18650official/HFUT-Innov-Project-InjectSystem/docs/pcb/V1.0/Schematic_monitor1_2024-12-04.pdf

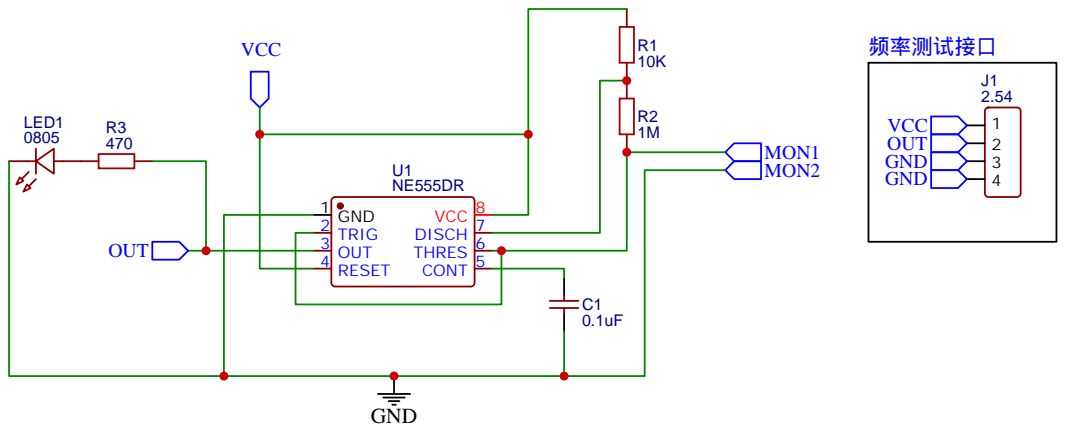
[picture p1: page 1]
