18650official/HFUT-Innov-Project-InjectSystem/firmware/stm32/Hardware/Encoder.c

#include "Encoder.h"

int16_t Encoder_Count;					//全局变量，用于计数旋转编码器的增量值
int8_t Encoder_ButtonState = 0;
int16_t t;

/**
  * 函    数：旋转编码器初始化
  * 参    数：无
  * 返 回 值：无
  */
void Encoder_Init(void)
{
	/*开启时钟*/
	RCC_APB2PeriphClockCmd(RCC_APB2Periph_GPIOA, ENABLE); //开启GPIOA时钟
	RCC_APB2PeriphClockCmd(RCC_APB2Periph_AFIO, ENABLE); 
	
	/*GPIO初始化*/
	GPIO_InitTypeDef GPIO_InitStructure;
	GPIO_InitStructure.GPIO_Mode = GPIO_Mode_IN_FLOATING;
	GPIO_InitStructure.GPIO_Pin = GPIO_Pin_5 | GPIO_Pin_6;
	GPIO_InitStructure.GPIO_Speed = GPIO_Speed_50MHz;
	GPIO_Init(GPIOA, &GPIO_InitStructure);

    GPIO_InitStructure.GPIO_Mode = GPIO_Mode_IPU; //设置按键端子为下拉输入。高电平触发
	GPIO_InitStructure.GPIO_Pin = GPIO_Pin_7;
	GPIO_InitStructure.GPIO_Speed = GPIO_Speed_50MHz;
	GPIO_Init(GPIOA, &GPIO_InitStructure);
	
	/*AFIO选择中断引脚*/
	GPIO_EXTILineConfig(GPIO_PortSourceGPIOA, GPIO_PinSource5);//将外部中断的0号线映射到GPIOB，即选择PB0为外部中断引脚
	GPIO_EXTILineConfig(GPIO_PortSourceGPIOA, GPIO_PinSource6);//将外部中断的1号线映射到GPIOB，即选择PB1为外部中断引脚
	GPIO_EXTILineConfig(GPIO_PortSourceGPIOA, GPIO_PinSource7);//将外部中断的1号线映射到GPIOB，即选择PB1为外部中断引脚
	
	/*EXTI初始化*/
	EXTI_InitTypeDef EXTI_InitStructure;						//定义结构体变量
	EXTI_InitStructure.EXTI_Line = EXTI_Line5 | EXTI_Line6;		//选择配置外部中断的0号线和1号线
	EXTI_InitStructure.EXTI_LineCmd = ENABLE;					//指定外部中断线使能
	EXTI_InitStructure.EXTI_Mode = EXTI_Mode_Interrupt;			//指定外部中断线为中断模式
	EXTI_InitStructure.EXTI_Trigger = EXTI_Trigger_Falling;		//指定外部中断线为下降沿触发
	EXTI_Init(&EXTI_InitStructure);								//将结构体变量交给EXTI_Init，配置EXTI外设

    EXTI_InitStructure.EXTI_Line = EXTI_Line7;
	EXTI_InitStructure.EXTI_LineCmd = ENABLE;					//指定外部中断线使能
	EXTI_InitStructure.EXTI_Mode = EXTI_Mode_Interrupt;			//指定外部中断线为中断模式
	EXTI_InitStructure.EXTI_Trigger = EXTI_Trigger_Falling;		//指定外部中断线为下降沿触发
	EXTI_Init(&EXTI_InitStructure);	
	
	/*NVIC中断分组*/
	NVIC_PriorityGroupConfig(NVIC_PriorityGroup_2);				//配置NVIC为分组2
																//即抢占优先级范围：0~3，响应优先级范围：0~3
																//此分组配置在整个工程中仅需调用一次
																//若有多个中断，可以把此代码放在main函数内，while循环之前
																//若调用多次配置分组的代码，则后执行的配置会覆盖先执行的配置
	
	/*NVIC配置*/
	NVIC_InitTypeDef NVIC_InitStructure;						//定义结构体变量
	NVIC_InitStructure.NVIC_IRQChannel = EXTI9_5_IRQn;			//选择配置NVIC的EXTI9-5线
	NVIC_InitStructure.NVIC_IRQChannelCmd = ENABLE;				//指定NVIC线路使能
	NVIC_InitStructure.NVIC_IRQChannelPreemptionPriority = 1;	//指定NVIC线路的抢占优先级为1
	NVIC_InitStructure.NVIC_IRQChannelSubPriority = 2;			//指定NVIC线路的响应优先级为1
	NVIC_Init(&NVIC_InitStructure);								//将结构体变量交给NVIC_Init，配置NVIC外设
}

/**
  * 函    数：旋转编码器获取增量值
  * 参    数：无
  * 返 回 值：自上此调用此函数后，旋转编码器的增量值
  */
int16_t Encoder_Get(void)
{
	/*使用Temp变量作为中继，目的是返回Encoder_Count后将其清零*/
	/*在这里，也可以直接返回Encoder_Count
	  但这样就不是获取增量值的操作方法了
	  也可以实现功能，只是思路不一样*/
	int16_t Temp;
	Temp = Encoder_Count;
	Encoder_Count = 0;
	return Temp;
}

int8_t Encoder_Readkey(void)
{
    if(Encoder_ButtonState)
    {
        Encoder_ButtonState = 0;
        return 1;
    }
    else return 0;
}

/**
  * 函    数：EXTI0外部中断函数
  * 参    数：无
  * 返 回 值：无
  * 注意事项：此函数为中断函数，无需调用，中断触发后自动执行
  *           函数名为预留的指定名称，可以从启动文件复制
  *           请确保函数名正确，不能有任何差异，否则中断函数将不能进入
  */
void EXTI9_5_IRQHandler(void)
{
	if (EXTI_GetITStatus(EXTI_Line6) == SET)		//判断是否是外部中断0号线触发的中断
	{
		/*如果出现数据乱跳的现象，可再次判断引脚电平，以避免抖动*/
		if (GPIO_ReadInputDataBit(GPIOA, GPIO_Pin_6) == 0)
		{
			if (GPIO_ReadInputDataBit(GPIOA, GPIO_Pin_5) == 0)		//PB0的下降沿触发中断，此时检测另一相PB1的电平，目的是判断旋转方向
			{
				Encoder_Count ++;					//此方向定义为反转，计数变量自减
			}
		}
		EXTI_ClearITPendingBit(EXTI_Line6);			//清除外部中断0号线的中断标志位
													//中断标志位必须清除
													//否则中断将连续不断地触发，导致主程序卡死
	}
	
    else if (EXTI_GetITStatus(EXTI_Line5) == SET)		//判断是否是外部中断0号线触发的中断
	{
		/*如果出现数据乱跳的现象，可再次判断引脚电平，以避免抖动*/
		if (GPIO_ReadInputDataBit(GPIOA, GPIO_Pin_5) == 0)
		{
			if (GPIO_ReadInputDataBit(GPIOA, GPIO_Pin_6) == 0)		//PB0的下降沿触发中断，此时检测另一相PB1的电平，目的是判断旋转方向
			{
				Encoder_Count --;					//此方向定义为反转，计数变量自减
			}
		}
		EXTI_ClearITPendingBit(EXTI_Line5);			//清除外部中断0号线的中断标志位
													//中断标志位必须清除
													//否则中断将连续不断地触发，导致主程序卡死
	}
	
    else if (EXTI_GetITStatus(EXTI_Line7) == SET)		//按键输入
	{
		t = 6000;
		while(t--);
		while(GPIO_ReadInputDataBit(GPIOA, GPIO_Pin_7) == 0);
   	    Encoder_ButtonState = 1;
		EXTI_ClearITPendingBit(EXTI_Line7);			//清除外部中断0号线的中断标志位
													//中断标志位必须清除
													//否则中断将连续不断地触发，导致主程序卡死
	}
}
