18650official/HFUT-Innov-Project-InjectSystem/firmware/stm32/Hardware/L298N.h

#ifndef __L298N_H__
#define __L298N_H__

#include "stm32f10x.h"

#endif

void L298N_Init(void);
void L298N_SetCompare(uint16_t Compare1, uint16_t Compare2);
void L298N_ConfigRotateDirect(int a,int b); //配置L298N两路电机的输出状态
void pump_set(uint8_t direct, uint16_t speed);
void valve_set(uint8_t direct, uint16_t speed);
